kanhaiyarathi/Home-Automation/README.md

# Home-Automation

Objective:
Creating a Smart Home Automation System using Raspberry Pi.

Instruments  Used :

●	Raspberry Pi 
●	Arduino(2),
●	 RF module(one receiver & one tranmitter)
●	 Ping Sensor(2)
●	 lm35 Temperature Sensor
●	 Breadboard 
●	Jumper Wires 
●	DC Motor & Motordriver (L293D)
●	LED’s.

Please have a look into the word file for more information. 

Demo representation link: https://youtu.be/bmMXYJsHiFw
