kanhaiyarathi/Home-Automation/Arduino_codes/ping/transmitter_433MHz/temp_tramnsmitter/temp_tramnsmitter.ino

#include <VirtualWire.h>
#include <RCSwitch.h>
 
RCSwitch mySwitch = RCSwitch();
int sensorPin = A0;    // select the input pin for the potentiometer
int sensorValue = 0;  // variable to store the value coming from the sensor

 
void setup() {
  Serial.begin(9600);
  // Transmitter is connected to Arduino Pin #10  
  mySwitch.enableTransmit(10);

}
 
void loop() {
  
 sensorValue = analogRead(sensorPin); //analog output of LM35
 
 sensorValue = sensorValue* 0.48828125; // Conversion to degrees
  Serial.println(sensorValue) ;
  mySwitch.send(sensorValue, 24); // transmitting Tempreture in Deg C
  delay(500); 
 
 
}
